Modellbahn-Treff/Otter_KehrschleifenBaustein/hardware/Kehrschleifenbaustein.kicad_pcb

## KiCad design hardware/Kehrschleifenbaustein.kicad_pcb (2026-08-21)

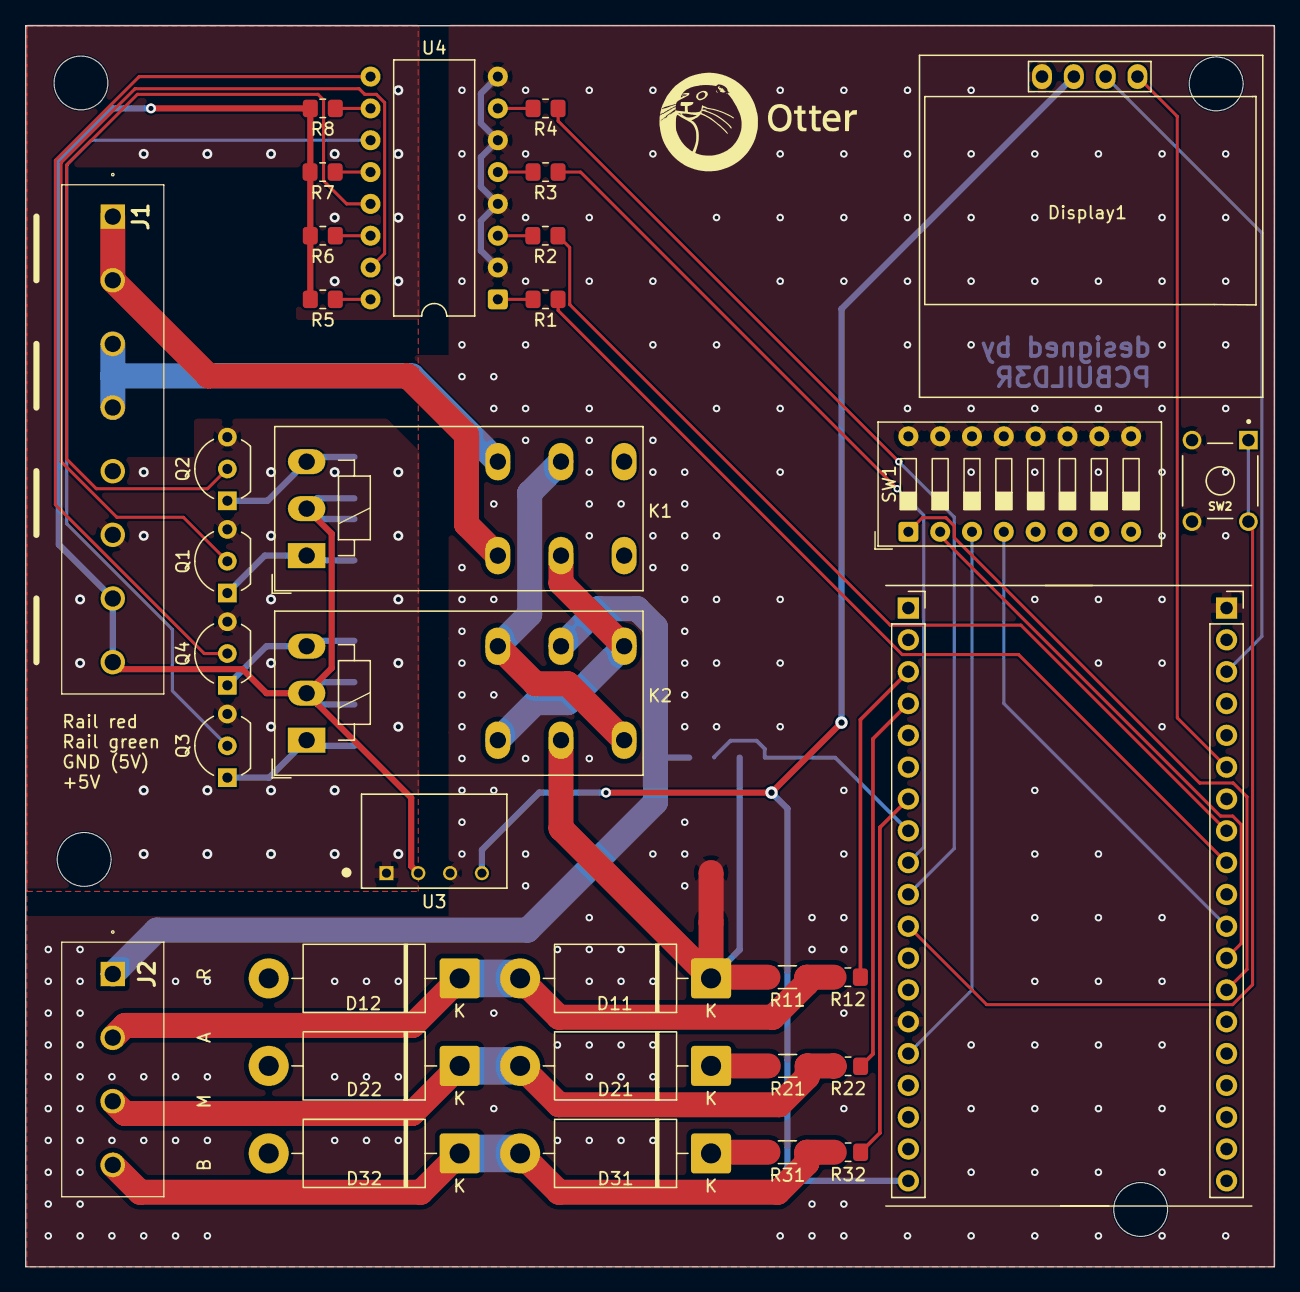
[picture p1: board Kehrschleifenbaustein.kicad_pcb from above]

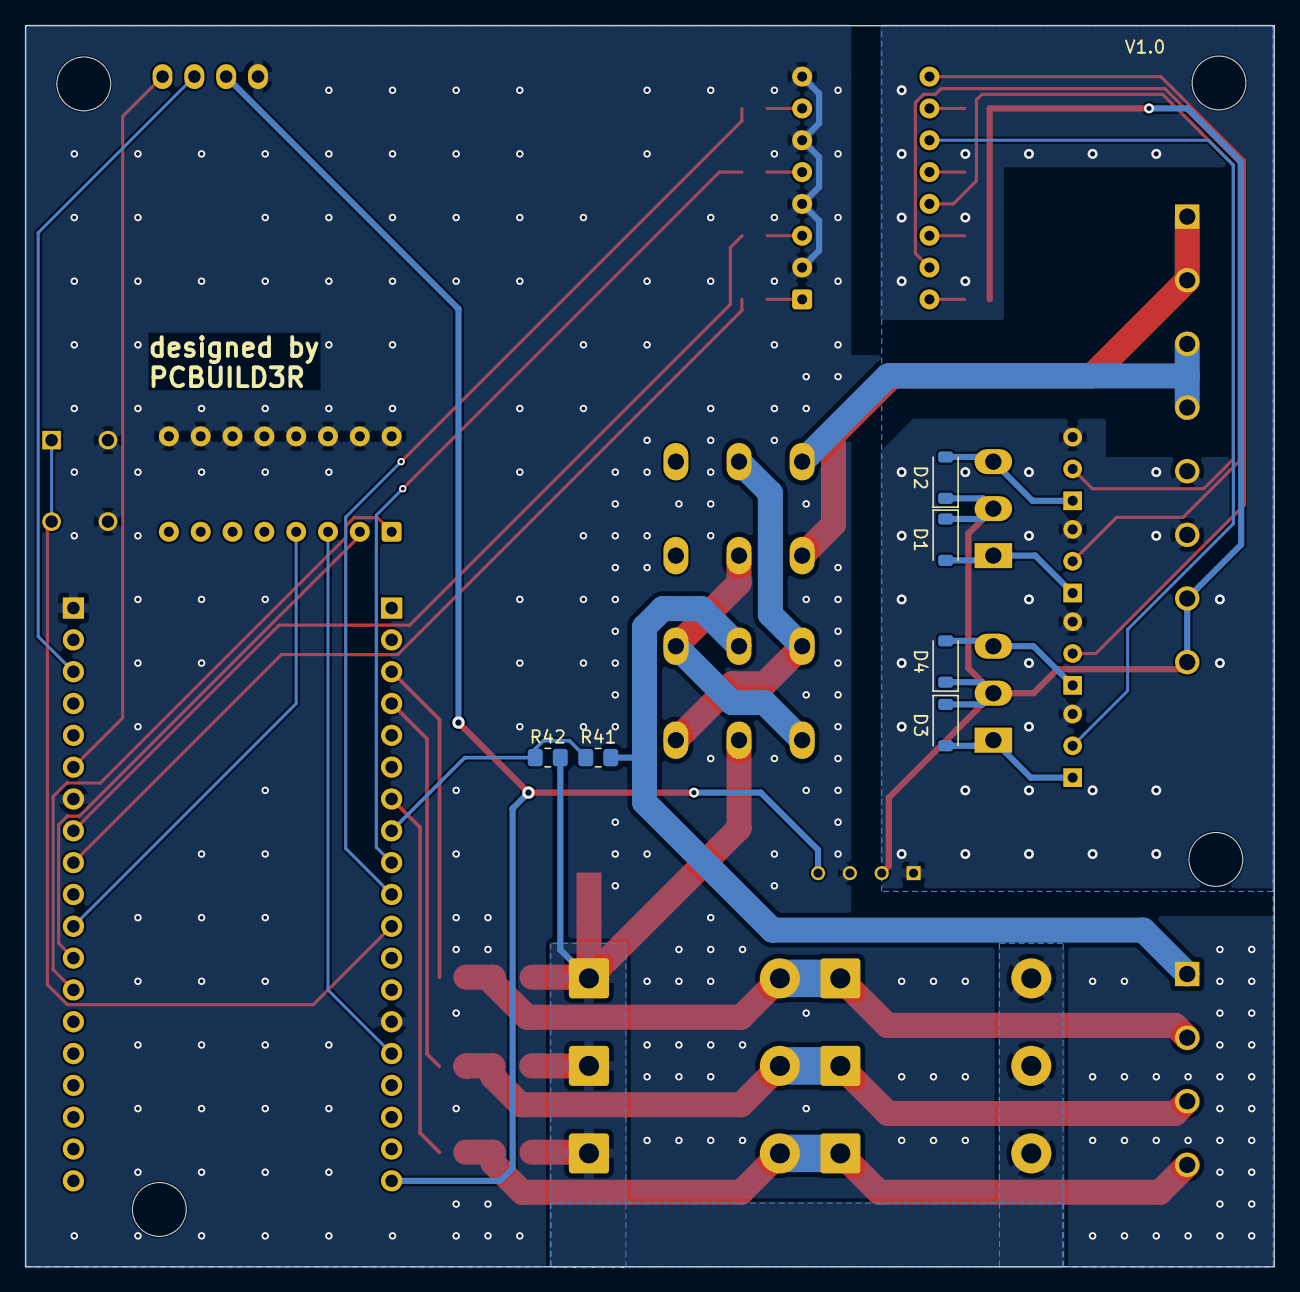
[picture p2: board Kehrschleifenbaustein.kicad_pcb from below]

Board: 2 copper layers, 99.7 x 99.1 mm, 46 parts (6 on the bottom side), 44 nets.

Parts:
D1, D2, D3, D4: 1N4148W; D_SOD-123
D11, D12, D21, D22, D31, D32: 1N5402; D_DO-201AD_P15.24mm_Horizontal
Display1: SSD1306; 128x64OLED
H1, H2, H3, H4: MountingHole; MountingHole_4.3mm_M4
J1: Conn_01x08; 1729186
J2: Conn_01x04; 1729144
K1, K2: RT42xFxx; Relay_DPDT_Schrack-RT2-FormC-Dual-Coil_RM5mm
NT1: NetTie_2; NetTie-2_SMD_Pad2.0mm
Q1, Q2, Q3, Q4: BC337; TO-92_Inline_Wide
R1, R2, R3, R4: 330; R_0805_2012Metric_Pad1.20x1.40mm_HandSolder
R5, R6, R7, R8: 1k; R_0805_2012Metric_Pad1.20x1.40mm_HandSolder
R11, R21, R31: 22; R_1206_3216Metric_Pad1.30x1.75mm_HandSolder
R12, R22, R32, R42: 10k; R_0805_2012Metric_Pad1.20x1.40mm_HandSolder
R41: 75k; R_0805_2012Metric_Pad1.20x1.40mm_HandSolder
SW1: SW_DIP_x08; SW_DIP_SPSTx08_Slide_9.78x22.5mm_W7.62mm_P2.54mm
SW2: 1-1825910-4; TE_1-1825910-4
U1: esp32_dev4_right
U2: esp32_dev4_left; esp32_dev_left
U3: SMU02L-05; SIP750W50P254L1160H1014Q4
U4: LTV-847M; DIP-16_W10.16mm

Connections:
5V0-isoliert: Display1.2 (VCC), U2.19 (5V), U3.4 (+VOUT)
+5V: D1.1 (K), D2.1 (K), D3.1 (K), D4.1 (K), J1.7, J1.8, K1.A3, K2.A3, R5.1, R6.1, R7.1, R8.1, U3.2 (+VIN)
+15V: J1.3, J1.4, K1.22
-15V: J1.1, J1.2, K1.12
ADC1_0: R12.2, U2.3 (GPI36)
ADC1_3: R22.2, U2.4 (GPI39)
ADC1_4: R32.2, U2.7 (GPIO32)
ADC1_5: R41.1, R42.2, U2.8 (GPIO33)
BTN_GPIO: SW2.1, SW2.2, U2.11 (GPIO27)
DIP_GPIO1: SW1.1, U1.26 (GPIO4)
DIP_GPIO2: SW1.3, U2.15 (GPIO13)
DIP_GPIO3: SW1.2, U1.27 (GPIO16)
DIP_GPIO4: SW1.4, U1.28 (GPIO17)
GND: J1.5, J1.6, Q1.3 (E), Q2.3 (E), Q3.3 (E), Q4.3 (E), U3.1 (-VIN)
GND-isoliert: Display1.1 (GND), NT1.2, SW1.9, SW1.10, SW1.11, SW1.12, SW1.13, SW1.14, SW1.15, SW1.16, SW2.3, SW2.4, U1.32 (GND), U1.38 (GND), U2.14 (GND), U3.3 (-VOUT), U4.2, U4.4, U4.6, U4.8
IN_A: D11.2 (A), D12.1 (K), J2.2, R11.1, R12.1
IN_B: D31.2 (A), D32.1 (K), J2.4, R31.1, R32.1
IN_M: D21.2 (A), D22.1 (K), J2.3, R21.1, R22.1
unnamed: D1.2 (A), K1.A1, Q1.1 (C)
unnamed: D2.2 (A), K1.A2, Q2.1 (C)
unnamed: D3.2 (A), K2.A1, Q3.1 (C)
unnamed: D4.2 (A), K2.A2, Q4.1 (C)
unnamed: Display1.3 (SCL), U1.36 (GPIO22)
unnamed: Display1.4 (SDA), U1.33 (GPIO21)
unnamed: K1.11, K2.12, K2.24
unnamed: K1.21, K2.14, K2.22
unnamed: Q1.2 (B), U4.15
unnamed: Q2.2 (B), U4.13
unnamed: Q3.2 (B), U4.11
unnamed: Q4.2 (B), U4.9
unnamed: R1.2, U4.1
unnamed: R2.2, U4.3
unnamed: R3.2, U4.5
unnamed: R4.2, U4.7
unnamed: R5.2, U4.16
unnamed: R6.2, U4.14
unnamed: R7.2, U4.12
unnamed: R8.2, U4.10
Rail_inner: J2.1, K2.21, R41.2
Rail_outer: D11.1 (K), D12.2 (A), D21.1 (K), D22.2 (A), D31.1 (K), D32.2 (A), K2.11, NT1.1, R11.2, R21.2, R31.2, R42.1
Relais_GPIO1: R1.1, U1.30 (GPIO18)
Relais_GPIO2: R2.1, U1.31 (GPIO19)
Relais_GPIO3: R3.1, U2.9 (GPIO25)
Relais_GPIO4: R4.1, U2.10 (GPIO26)
