Modellbahn-Treff/Otter_KehrschleifenBaustein/firmware/main/otter.h

// Copyright (C) 2026 Modellbahn-Treff for Kids GmbH
// SPDX-License-Identifier: GPL-3.0-or-later

#pragma once
#include <stdint.h>

extern const uint8_t sensePin[3];
extern const uint8_t voltagePin;
extern const uint8_t dipPin[4];
extern const uint8_t buttonPin;
extern const uint8_t swapRelayPin[2];
extern const uint8_t switchRelayPin[2];
extern const char *MqttRefresh;
