Modellbahn-Treff/Otter_KehrschleifenBaustein/(commit log)

2026-06-07 update DRC
    [Kehrschleifenbaustein.kicad_pcb]
2026-08-21 Final design 1.0
    [Kehrschleifenbaustein.kicad_pcb]
2026-09-06 Add OLED display functionality to the KehrschleifenBaustein firmware
    - Implemented SSD1306 OLED display driver in display.cpp and display.h.
    - Updated README.md to include display status and usage instructions.
    - Modified CMakeLists.txt to include display source files.
    - Enhanced kb.cpp to integrate display updates with state changes and button presses.
    - Added display refresh logic to periodically update the OLED screen with current state information.
2026-09-06 Implement relay pulse queue and update GPIO configuration for relay control
2026-09-06 Enhance KehrschleifenBaustein firmware: implement relay control, improve display updates, and add MQTT state publishing
